Smash-Shimizu/personalized_programmable_penlight_platform/README.md

# personalized_programmable_penlight_platform
This Repository contains prototypes of PPPP (Personalized Programmable Penlight Platform)!
