Smash-Shimizu/personalized_programmable_penlight_platform/docs/Paper_of_PPPP.pdf

## RGB 色設定と一覧表示・直接選択を可能とする プログラマブルペンライトプラットフォームの提案

Proposal of a Programmable Penlight Platform Enabling RGB Color Configuration and Color List

### Display with Direct Selection

スマッシュシミズ（無所属）

SMASH SHIMIZU (Independent)

Existing penlights do not necessarily provide both flexible RGB color configuration and color list display with direct selection. This paper proposes a Programmable Penlight Platform enabling these capabilities, referred to as the Personalized Programmable Penlight Platform (PPPP). Two penlights with different user interfaces are implemented as customization examples to illustrate how the proposed platform can be customized.

Key Words: Penlight, Programmable Device, Embedded Systems, User Interface Design

### 1 緒言

近年，音楽アーティストの応援ではペンライトが広く用いられ ている．特にグループアーティストにおいてメンバーカラーが存 在する場合，場面に応じてペンライトの色を各メンバーカラーに 切り替えることがある．
このような需要を満たす代表的なペンライトに「キングブレー ド X10 V[1]」がある．キングブレード X10 V は RGB の値を 用いた色設定機能を持ち，多様なメンバーカラーに対応可能であ る．しかし，基本的にはスイッチを複数回操作してサイクリック に色を変更することになり，選択可能な色数が多いときに操作回 数が増加してしまう．一方で，「すとぷり　いちごペンライト！！ [2]」は 6 色分のスイッチがついており，選択可能な色を一覧しな がらワンタッチで色を選択できるが，あらかじめ決められた 6 色 に限定されている．そこで，RGB 値による色設定と色の一覧表 示・直接選択を両立するペンライトが求められる．
しかし，これら二つの機能だけでは不十分な場合もある．例 えば，使用したい色の数が一覧表示可能な色数を超える場合には ページング機能が必要となる．また，複数色を同時に発光させた い場合には，複数の LED を異なる色で発光させることで実現で きる．このようにユーザによって必要な機能は異なるため，必要 とする機能を選択的に実装できる構成は有用であると考える． そこで，本研究ではハードウェアおよびソフトウェアを変更する ことでユーザの需要に応じて機能をカスタマイズできるプログラム 可能なペンライトプラットフォーム（Personalized Programmable Penlight Platform: PPPP）を提案する．さらに PPPP に基づ くカスタマイズの例として，RGB 値による色設定と色の一覧表 示・直接選択を実現する，UI の異なる二種類のペンライトを試 作した．
本研究の主な貢献は，RGB 値による色設定と一覧表示・直接 選択を両立する二種類のペンライトを実装したこと，および共通 ハードウェアを再利用しながら UI 部を変更できる PPPP の構 成を示したことである．

### 2 PPPP の概要

本章では PPPP の構成とカスタマイズ方法について述べる． PPPP は，共通部分を再利用しながら，ユーザの要求に応じて ハードウェアおよびソフトウェアを変更できるペンライト開発基 盤である．PPPP では，設計成果物を共有・再利用することで多 様なカスタマイズを促進することを目指す．
PPPP のハードウェア構成概念図を図 1 に示す．緑色は共通 部分，黄色はカスタマイズ対象を表す．PPPP のハードウェア は，発光部，電源部および UI 筐体から構成され，UI 筐体には， 共通部分であるマイコンボードと，カスタマイズ対象である拡張 ハットおよび UI 用デバイスを収容する．ハードウェアのカスタ マイズ対象を UI 部に限定するのは，長さや照度などを市販の一

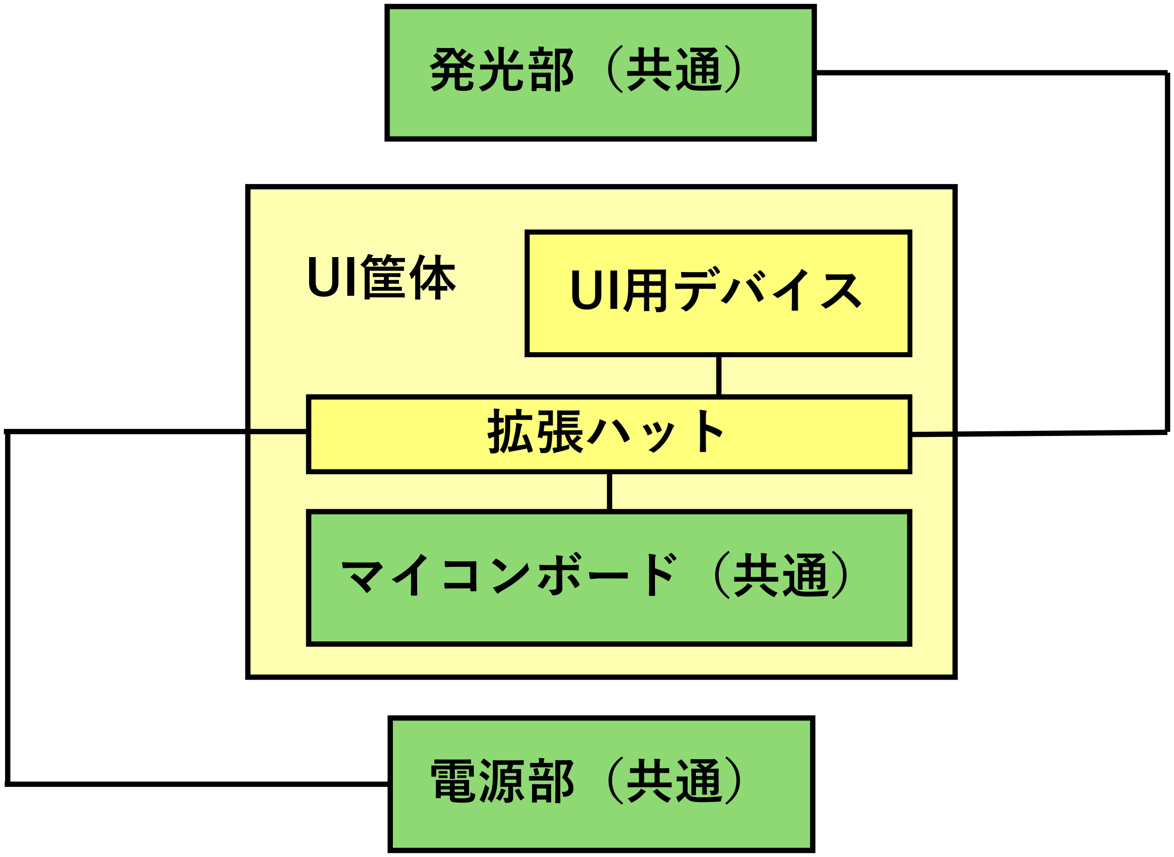
[picture p1: figure]
発光部（共通）; マイコンボード（共通）; 電源部（共通）

Fig.1 Hardware configuration of PPPP

般的なペンライトと同等にすることを前提とするためである．た だし，高い照度を得ることを目的としない LED 数の増減は許容 する．また，発光パターンや UI 用デバイスの実現に必要な場合 には，電源の増設も許容する．
ハードウェアのカスタマイズでは，必要な入力装置や表示器を 実装した UI 用デバイス，それらをマイコンボードに接続するた めの拡張ハットおよび UI 筐体を設計する．拡張ハットを用いる ことにより，配線変更を拡張ハットに集約し，マイコンボードを 再利用してコストを抑えながら UI の試作を繰り返すことができ る．このとき，マイコンボードおよび発光部の LED を含む入出 力デバイスへの電源供給もこの拡張ハットを介して行われる．ま た，UI 筐体は発光部および電源部と接続可能であるようにする 必要がある．
ソフトウェアのカスタマイズでは，マイコンボード上で動作す るプログラムを変更することにより，入力処理や表示処理，色選 択アルゴリズムなどを変更する．なお，マイコンボードは USB などのプログラム書き込み用インターフェースを持っているとす る．また，色セットなどの，プログラムを変更せずに変更可能な 情報は設定ファイルや定義ファイルとして分離する．
PPPP は図 2 に示すような，ハードウェアとソフトウェアを 横断した階層モデルとして整理できる．ユーザはこのモデルにお いて，必要に応じて他者が公開した下位の階層の設計成果物を再 利用しながら，必要な階層をカスタマイズすることができる．

### 3 PPPP のリファレンス実装およびカスタマイズ例

本章では，前述の PPPP のリファレンス実装および PPPP に 基づくカスタマイズ例を 2 例示す．

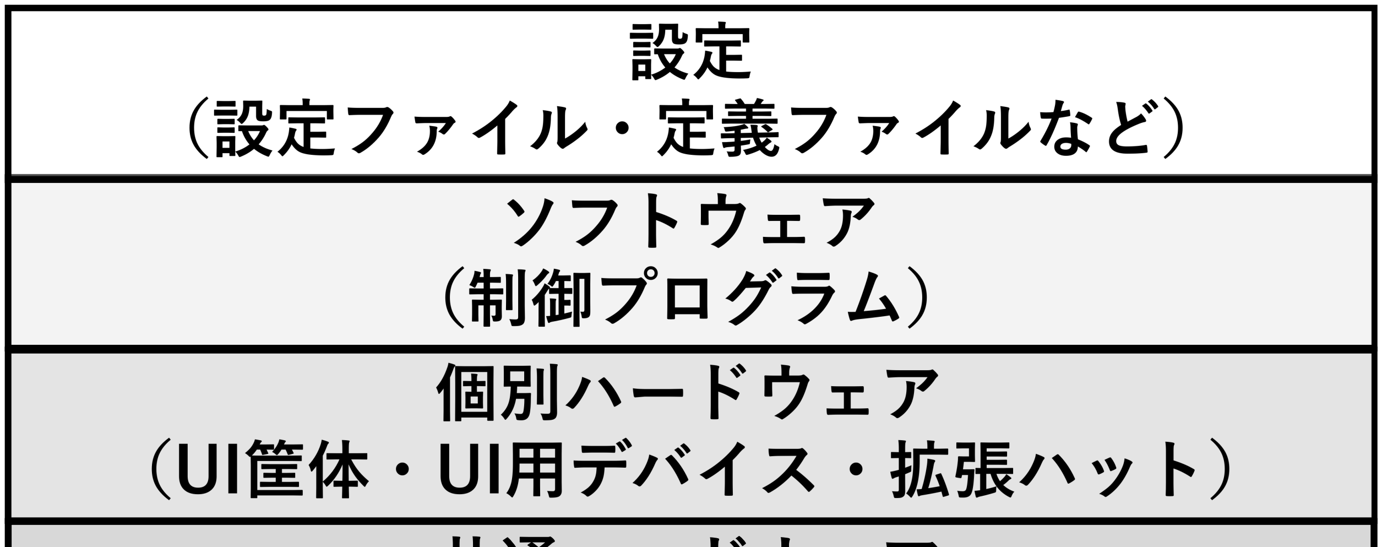
[picture p2: figure]

共通ハードウェア
（発光部・電源部・ 部のマイコンボード）

可変

Fig.2 Layered model of PPPP

### 3.1 PPPP のリファレンス実装

図 3 に PPPP のリファレンス実装における共通部分の外観を 示す．
発光部は LED テープ [3] を軸材に貼り付け，ペンライトトッ プを取り付けたものである．LED テープは 1 本の信号線で複数 の LED セルを制御できるため，マイコンボードの GPIO を節約 できる．また，セルの数はテープの切断および接続によって容易 に変更できる．
電源部は単 4 乾電池 3 本を収納可能な電池ボックスとなって おり，スイッチで電源の ON/OFF が行える．
UI 部に用いるマイコンボードには Seeed Studio XIAO SAMD21[4] を用いた．Seeed Studio XIAO SAMD21 は USB-C を介して Arduino IDE で開発したスケッチを書き込むことがで きる．また，デジタル・アナログ入出力，PWM や DAC に加え， I2C・UART・SPI といったインターフェースを備えており，様々 な UI デバイスに対応できる．
また，拡張ハットを容易に設計・製作できるようにするため， 図 4 に示すような Seeed Studio XIAO SAMD21 のピン配置を 変更する共通の中間基板を用意した．カスタマイズ時にはこの中 間基板に適合する拡張ハットを作製する．

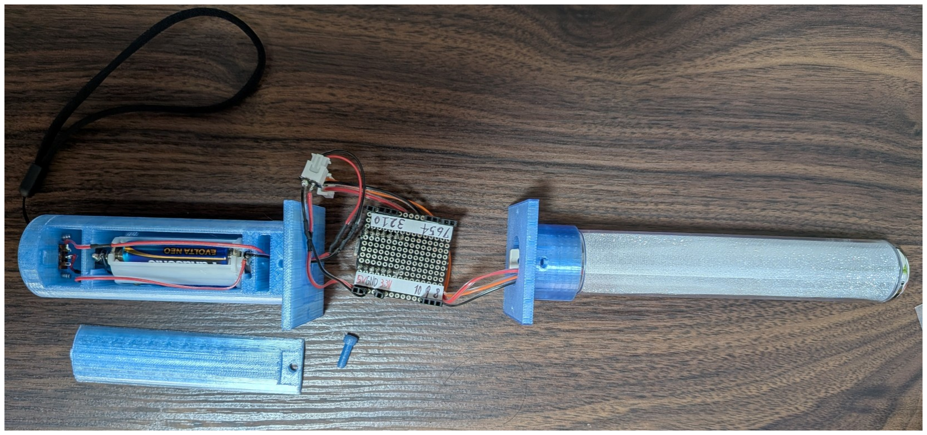
[picture p3: figure]

Fig.3 Overview of the PPPP reference implementation

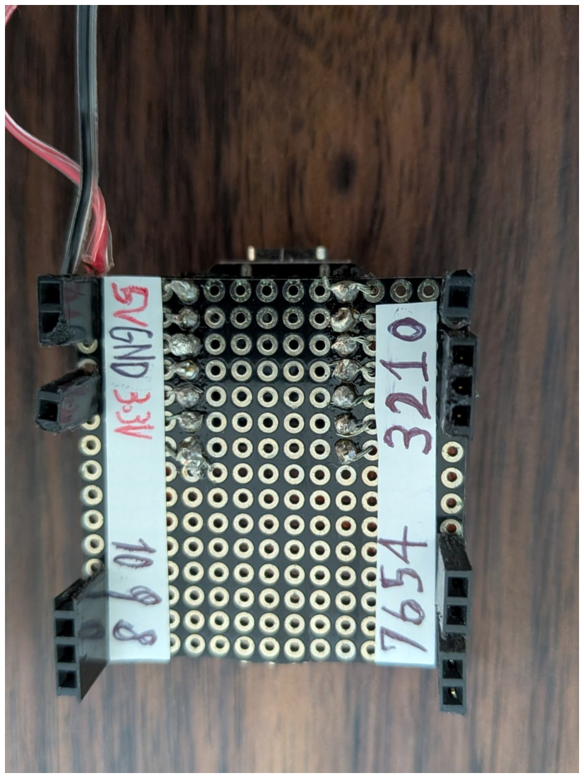
[picture p4: figure]
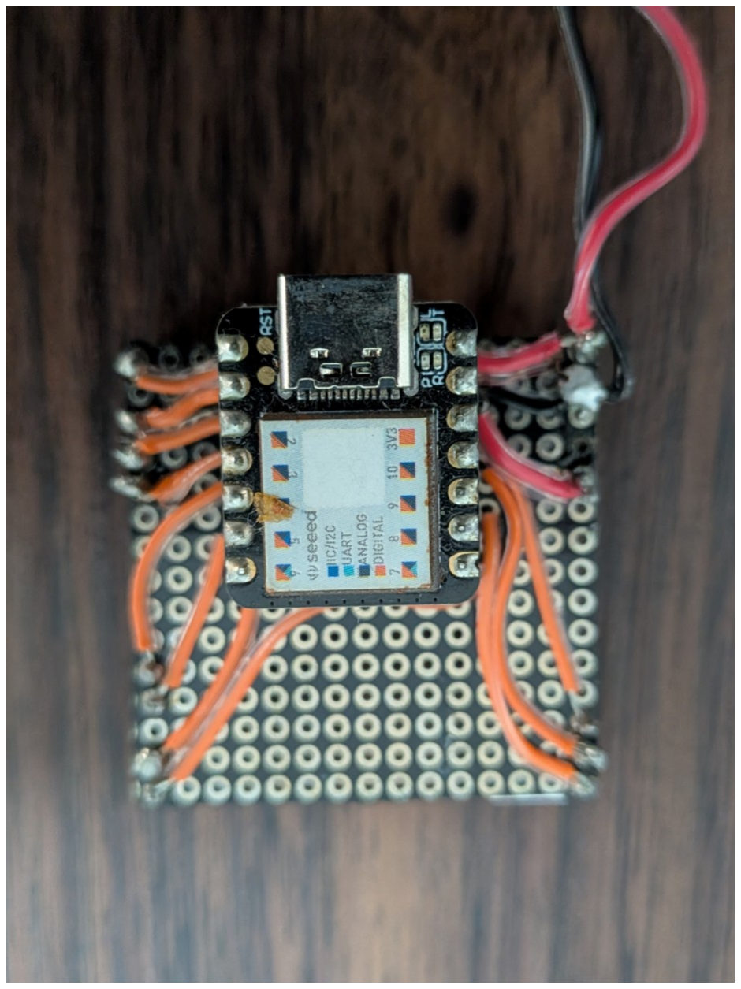
[picture p5: figure]

Fig.4 Common intermediate board for the Seeed Studio

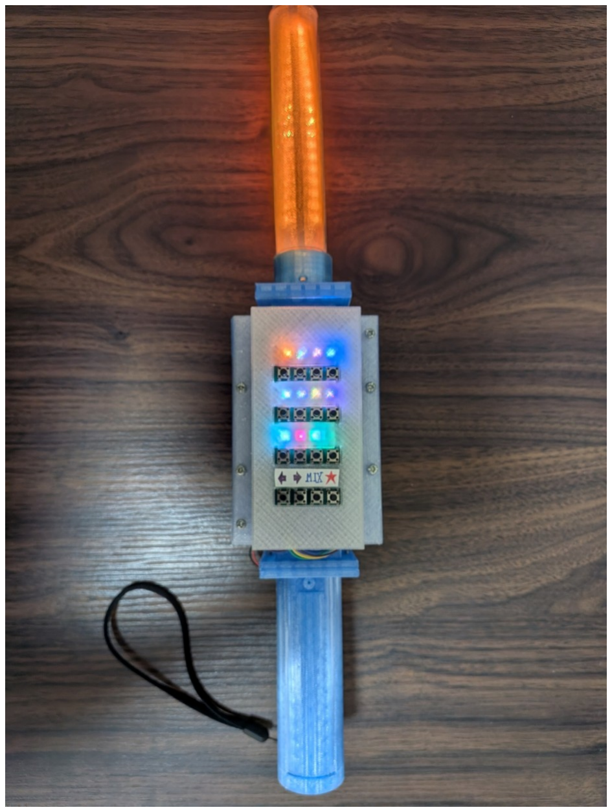
[picture p6: figure]
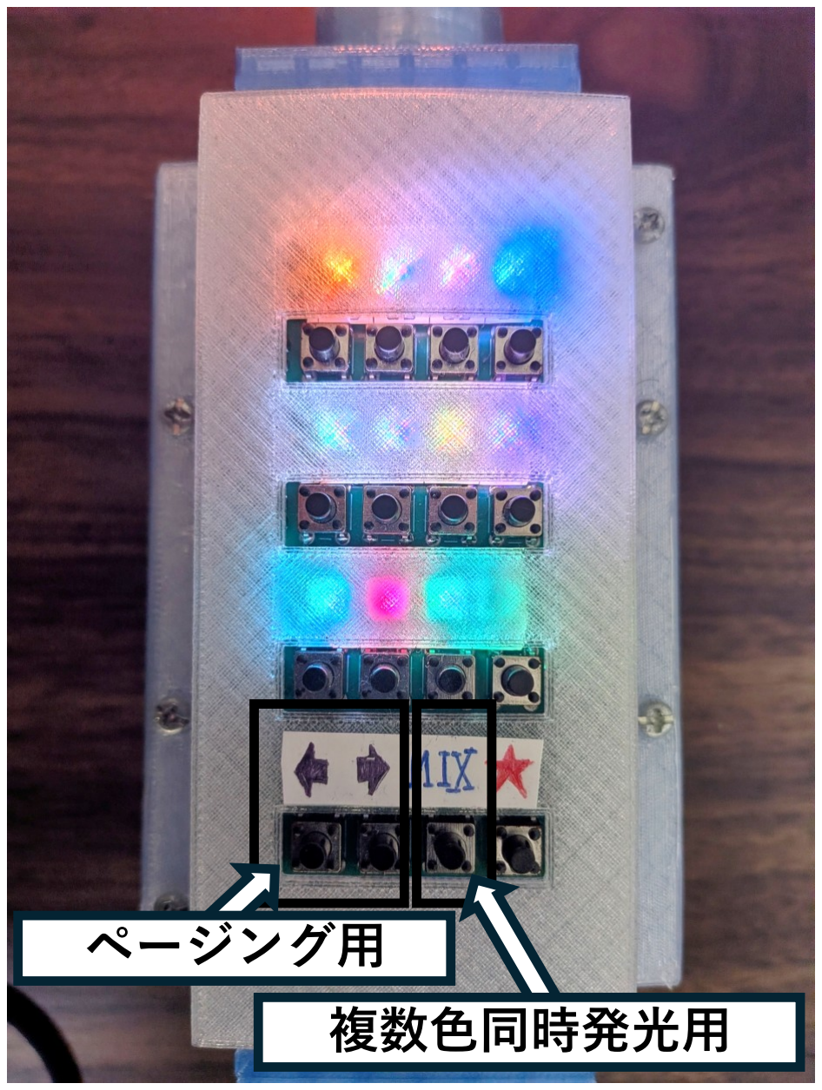
[picture p7: figure]
複数⾊同時発光⽤

XIAO SAMD21 | ページング⽤

Fig.5 Overview of the 16-button penlight

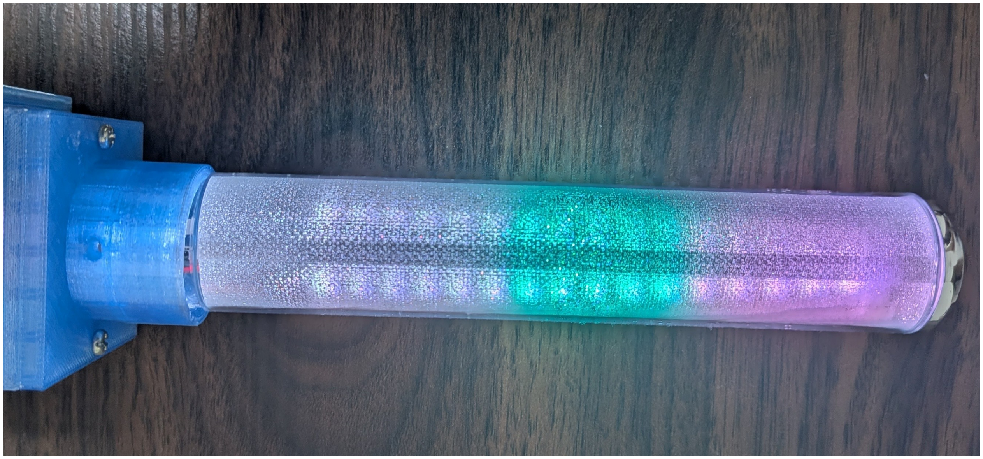
[picture p8: figure]

Fig.6 Simultaneous illumination in multiple colors

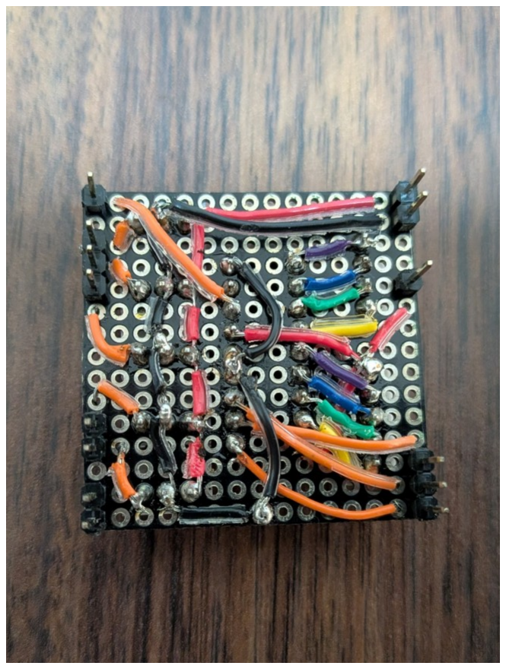
[picture p9: figure]
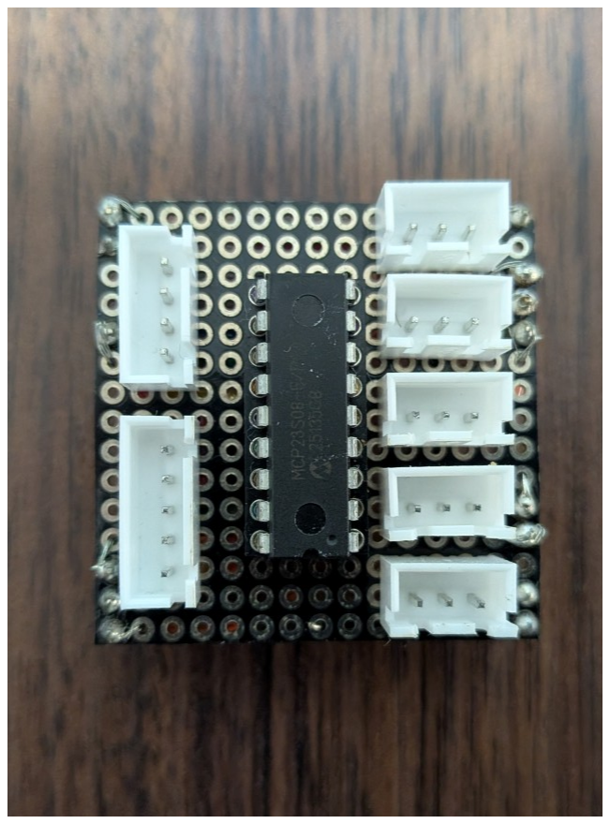
[picture p10: figure]

Fig.7 Expansion HAT for the 16-button penlight

### 3.2 カスタマイズ例：16 ボタン・ページング・複数色同時発光

図 5 にペンライトの外観を示す．UI 部には 16 個のスイッチ があり，上の 12 個は色選択スイッチ，下の 4 つは制御スイッチ である．色選択スイッチの上部には色表示用の LED が取り付け られ，色選択スイッチを押すことで，ペンライトをそのスイッチ に対応する色で発光させる．また，ページング用制御スイッチに よって色セットのページを切り替えることで，12 色を超える色 を扱うことができる．さらに，複数色同時発光用制御スイッチに よって発光モードを切り替える．複数色同時発光モードでは，図 6 のように選択した色数に応じて 16 個の LED セルをほぼ均等 に割り当て，最大 16 色を同時に発光できる．制御スイッチの 1 つは未割当てであり，ソフトウェアの変更で機能を追加できる． 図 7 に拡張ハットの外観を示す．GPIO の不足を補うために IO 拡張 IC を用い，その先にキーマトリクス方式を用いた自作 の入力モジュールを接続するためのコネクタを取り付けた．発光 部およびスイッチ上部の色表示用 LED についても，同様にコネ クタを取り付けた．このとき，入力モジュールはマイコンボード の 3.3 V ピンから，LED は電源部の 4.5 V から給電する．

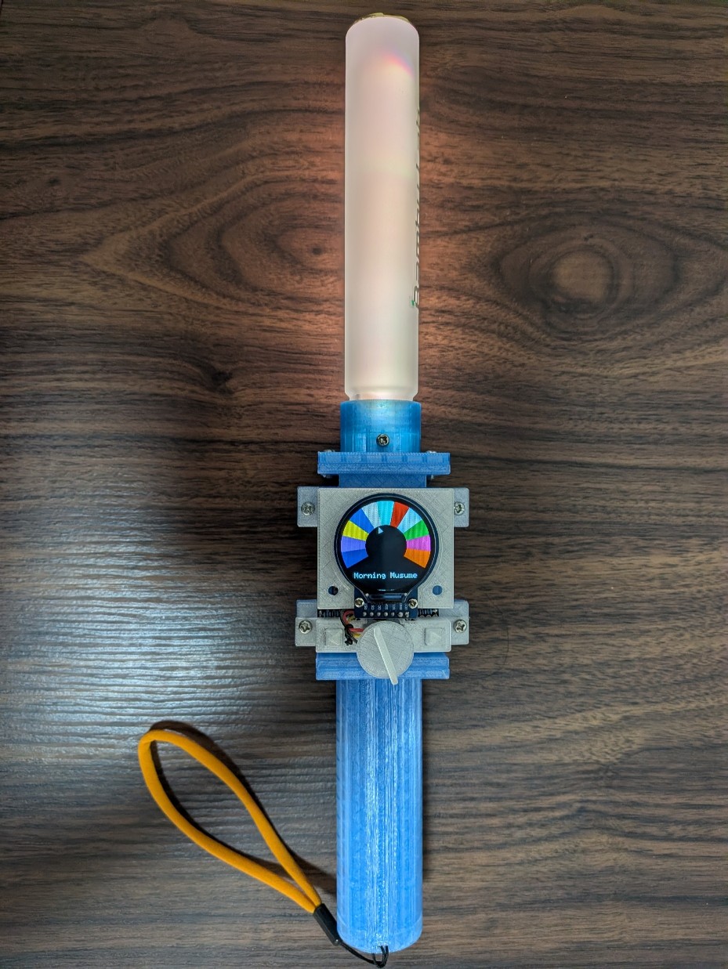
[picture p11: figure]
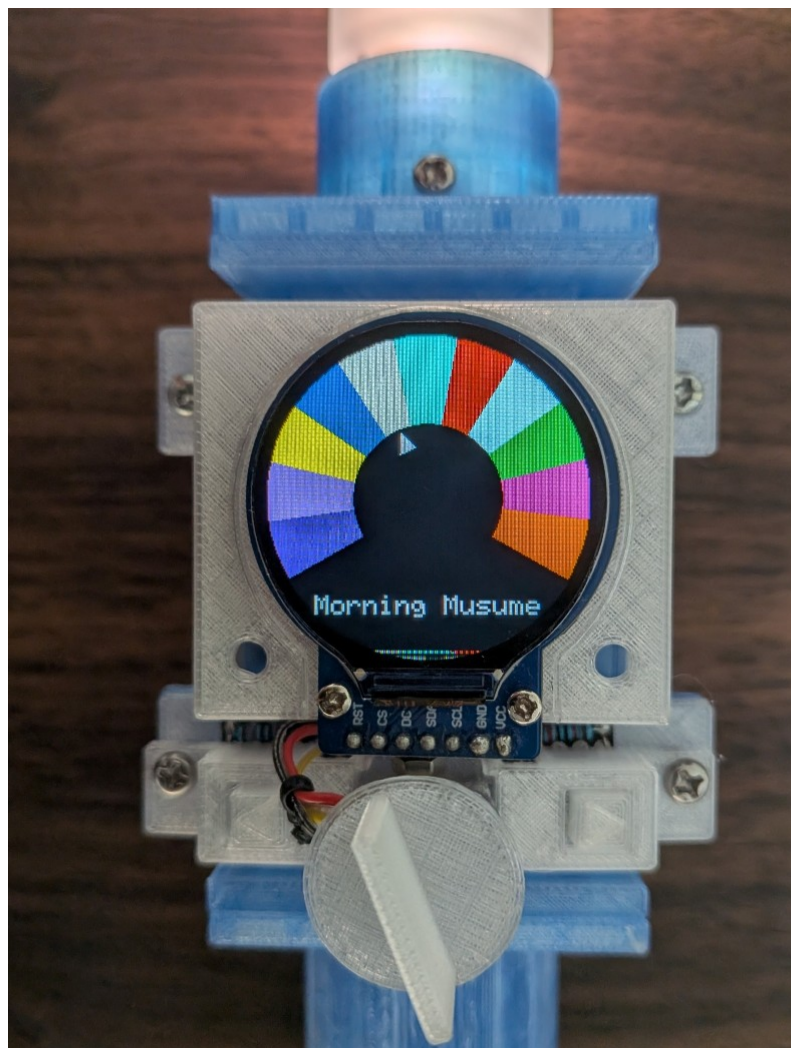
[picture p12: figure]

Fig.8 Overview of the dial-based penlight

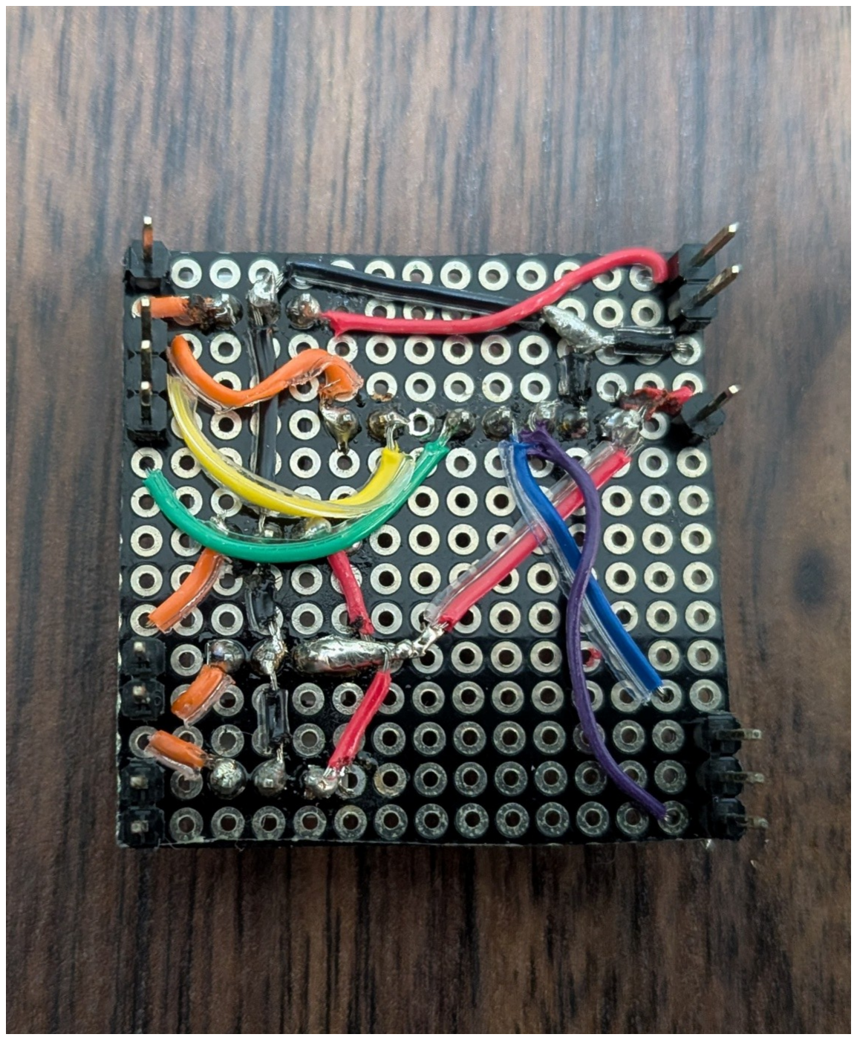
[picture p13: figure]
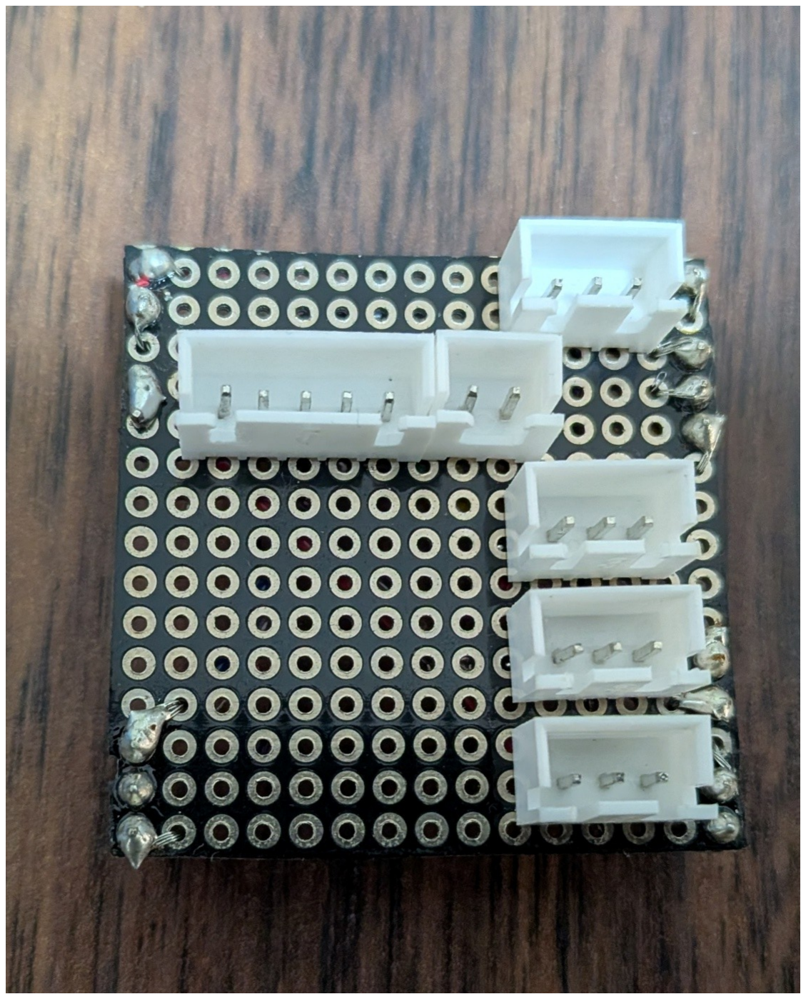
[picture p14: figure]

Fig.9 Expansion HAT for the dial-based penlight

### 3.3 カスタマイズ例：ダイヤル・ページング・色一覧表示

図 8 にペンライトの外観を示す．UI 部は 2 つのスイッチと可 変抵抗によるダイヤル，円形ディスプレイ [5] からなる．円形ディ スプレイには選択可能な色を一覧表示する．ダイヤルを回すこと でカーソルを移動させて色を選択し，選択した色でペンライトを 発光させることができる．また，2 つのスイッチによって色セッ トのページを切り替えることができる．
図 9 に拡張ハットの外観を示す．拡張ハットには，発光部の LED，可変抵抗および円形ディスプレイを接続するためのコネク タを取り付けた．このとき，円形ディスプレイおよび可変抵抗は マイコンボードの 3.3 V ピンから，LED は電源部の 4.5 V から 給電する．

### 4 結言

本稿では，共通ハードウェアを再利用しながら UI 部をカスタ マイズ可能なペンライトプラットフォーム PPPP を提案し，そ のリファレンス実装を行った．また，RGB 値による色設定と一 覧表示・直接選択を両立する 2 種類のペンライトを PPPP のカ スタマイズ例として試作した．
デザイン全般において，柔軟さを高めることで複雑さが増す場 合がある [6]．PPPP においても，カスタマイズの柔軟性と容易 さには同様のトレードオフがあると考えられる．例えば，キング ブレード X10 V はカスタマイズ対象を色の設定に限定する代わ りに，スマートフォンアプリによる容易なカスタマイズを実現し ているといえる．一方，本稿で提案した PPPP はカスタマイズ の柔軟性を重視した設計とした．今後は，カスタマイズの柔軟性 と容易さのバランスを考慮しながら，プラットフォームとしての あり方を検討する．

参考文献

[1] RUIFAN JAPAN, ”KING BLADE X10 V”, https://ruifan.co.jp/products/pro_kb_x5.html （2026 年 8 月 14 日閲覧）
[2] STPR ONLINE STORE, ”すとぷり　いちごペンライト！！”, https://store.stpr.com/products/stpr00000139?srsltid=AfmBOorjGVgUbv_g7Vme43BAj-hQ01ttg68M9rYwrN5OHh83VLJ9NUNF
（2026 年 8 月 14 日閲覧）
[3] BTF-LIGHTING, ”WS2812B-ECO Addressable LED Strip Light DC5V — RGB 5050 SMD Pixel Tape for Home DIY”, https://www.btf-lighting.com/en-intl/collections/all-products/products/ws2812b-eco-led-pixel-strip （2026 年 8 月 14 日閲覧）
[4] Seeed Studio Wiki, ”Seeed Studio XIAO SAMD21 入門ガイド”, https://wiki.seeedstudio.com/ja/Seeeduino-XIAO/（2026 年 8 月 14 日閲覧）
[5] Waveshare Electronics, ”1.28inch LCD Module”, https://www.waveshare.com/wiki/1.28inch_LCD_Module （2026 年 8 月 14 日閲覧）
[6] William Lidwell, Kritina Holden, Jill Butler, 郷司陽子（訳）, ”Design Rule Index 要点で学ぶ、デザインの法則１５０”, 株式会 社ビー・エヌ・エヌ新社, pp.114-115, 2015.
